SilkyPants/YAAB/Schematics/Revive Board/board.png

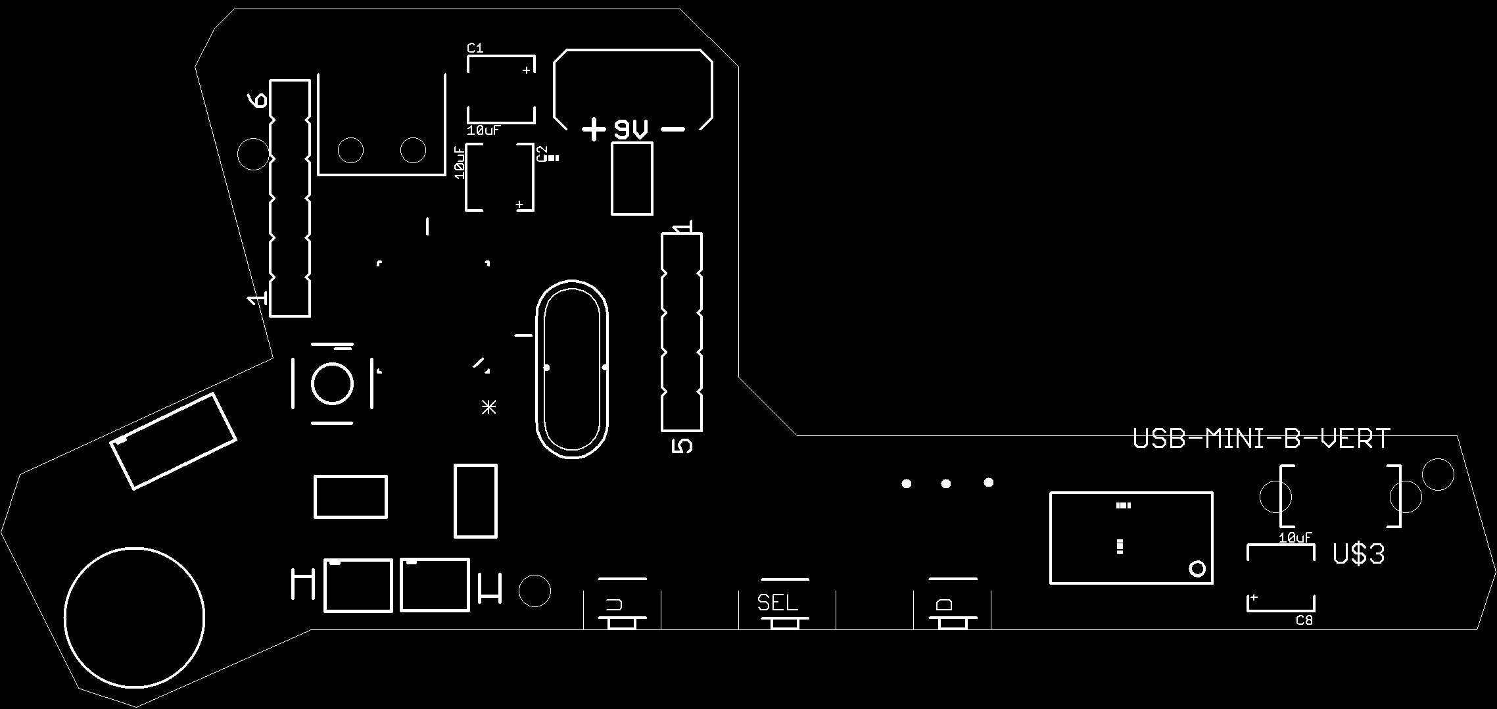
Schematics/Revive Board/board.png
