SilkyPants/YAAB/Schematics/YAAB/YAAB.brd

## EAGLE design Schematics/YAAB/YAAB.brd (2015-05-04)

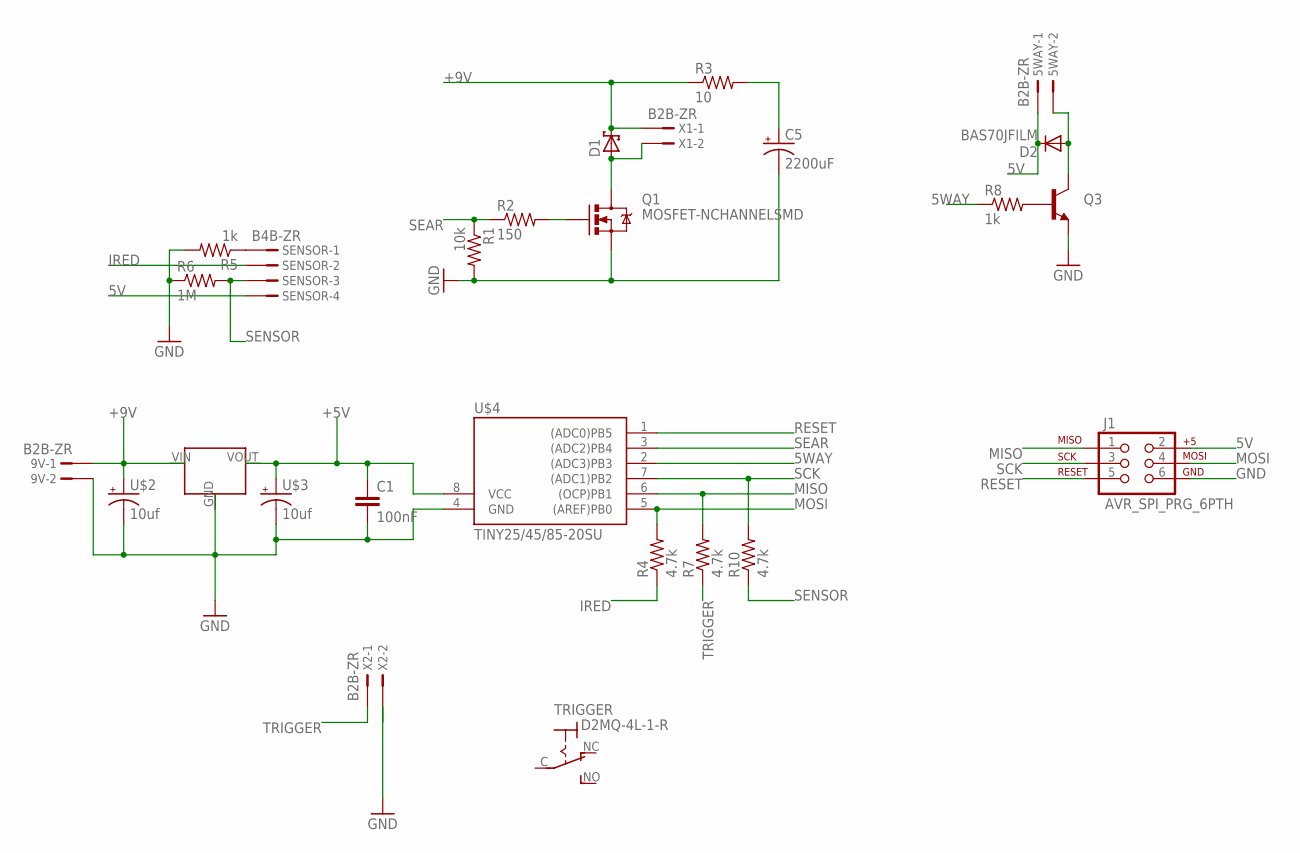
[picture p2: schematic YAAB.sch]

Parts:
5WAY, 9V: B2B-ZR; B2B-ZR@1
C1: 100nF; CAP-PTH-SMALL-KIT
C5: 2200uF; AVES***M**B
D1: SCHOTTKY-DIODESMC; SMC
D2: BAS70JFILM; SOD-323
J1: AVR_SPI_PRG_6PTH; 2X3
Q1: MOSFET-NCHANNELSMD; SOT23-3
Q3: TRANSISTOR_NPNSOT89; SOT89
R1: 10k; 0603-RES
R2: 150; 0603-RES
R3: 10; 0603-RES
R4, R7, R10: 4.7k; 1206
R5, R8: 1k; R0603
R6: 1M; R0603
SENSOR: B4B-ZR
TRIGGER: D2MQ-4L-1-R
U$1: L78M05C; SOT-89
U$2, U$3: 10uf; AVES***M**B
U$4: TINY25/45/85-20SU; SOIC8
X1: B2B-ZR; B2B-ZR@1
X2: B2B-ZR

Connections:
5V: 5WAY.1, D2.1 (C), J1.2, SENSOR.4
5WAY: R8.1, U$4.2 ((ADC3)PB3)
+5V: C1.1, U$1.VOUT (OUT), U$3.P$1+ (+), U$4.8 (VCC)
+9V: 9V.1, D1.C, R3.1, U$1.VIN (IN), U$2.P$1+ (+), X1.1
GND: 9V.2, C1.2, C5.P$2- (-), J1.6, Q1.2 (S), Q3.3 (E), R1.2, R5.2, R6.1, U$1.GND, U$2.P$2- (-), U$3.P$2- (-), U$4.4 (GND)
IRED: R4.1, SENSOR.2
MISO: J1.1, R7.2, U$4.6 ((OCP)PB1)
MOSI: J1.4, R4.2, U$4.5 ((AREF)PB0)
unnamed: Q1.1 (G), R2.2
unnamed: D1.A, Q1.3 (D), X1.2
unnamed: C5.P$1+ (+), R3.2
unnamed: R5.1, SENSOR.1
unnamed: 5WAY.2, D2.2 (A), Q3.2 (C)
unnamed: Q3.1 (B), R8.2
RESET: J1.5, U$4.1 ((ADC0)PB5)
SCK: J1.3, R10.2, U$4.7 ((ADC1)PB2)
SEAR: R1.1, R2.1, U$4.3 ((ADC2)PB4)
SENSOR: R6.2, R10.1, SENSOR.3
TRIGGER: R7.1, X2.1, X2.2

Board: 2 copper layers, 26 parts (0 on the bottom side), 19 nets, no tracks yet.
