SilkyPants/YAAB/Schematics/Revive Shield/shield.brd

## EAGLE design Schematics/Revive Shield/shield.brd (2015-05-04)

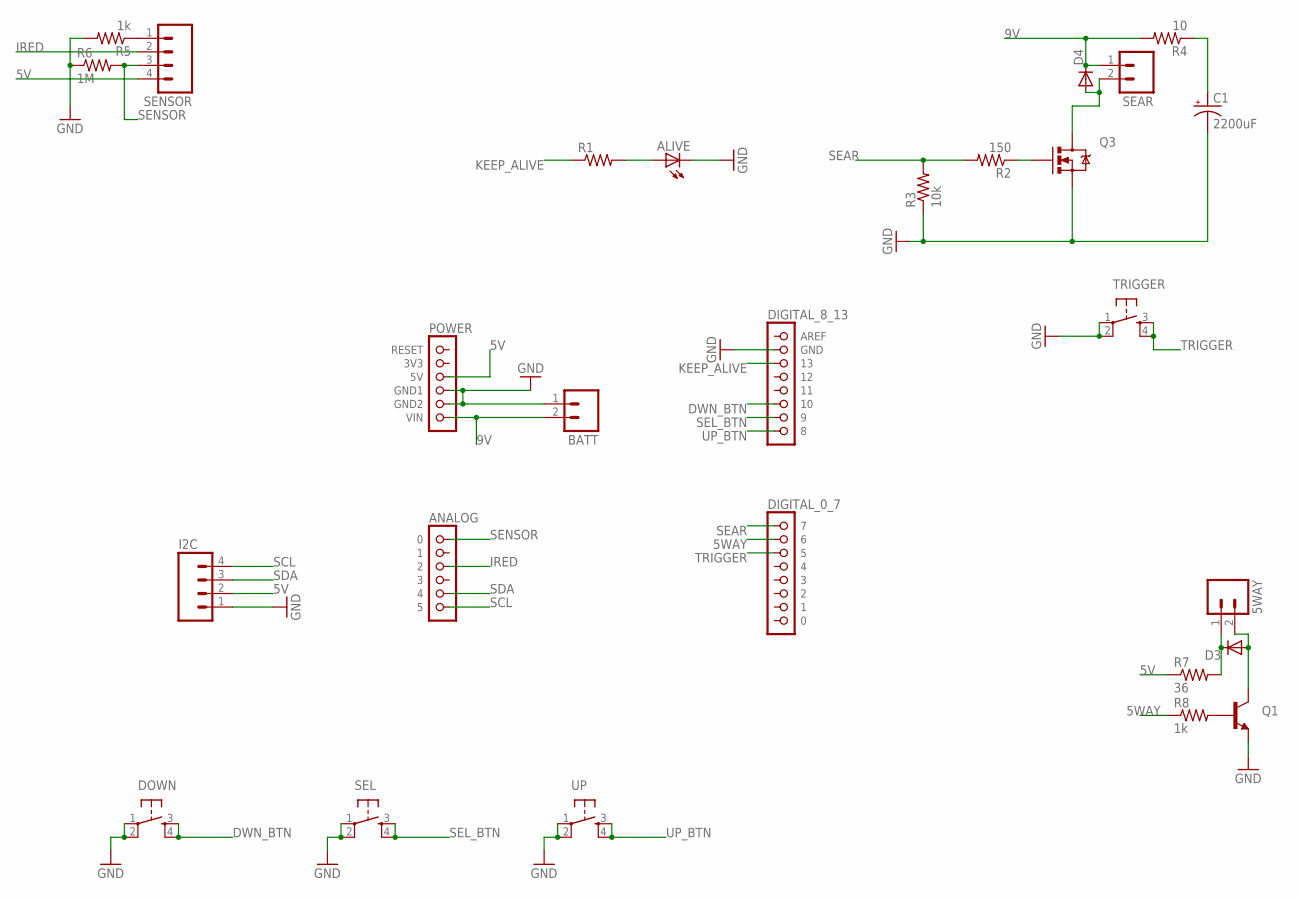
[picture p3: schematic shield.sch]

Parts:
5WAY: M02PTH; 1X02
ALIVE: LED3MM
BATT: M02PTH; 1X02
C1: 2200uF; CPOL-RADIAL-1000UF-25V
D3, D4: DIODEPTH; DIODE-1N4001
DOWN: TAC_SWITCHPTH; TACTILE-PTH
I2C: M04PTH; 1X04
Q1: TRANSISTOR_NPNTO-92-AMMO; TO-92-AMMO
Q3: MOSFET-NCHANNELPTH2; TO220V
R1: RESISTORPTH-1/4W; AXIAL-0.4
R2: 150; AXIAL-0.4
R3: 10k; AXIAL-0.4
R4: 10; AXIAL-0.4
R5, R8: 1k; AXIAL-0.4
R6: 1M; AXIAL-0.4
R7: 36; AXIAL-0.4
SEAR: M02PTH; 1X02
SEL: TAC_SWITCHPTH; TACTILE-PTH
SENSOR: M04PTH; 1X04
TRIGGER: TAC_SWITCHPTH; TACTILE-PTH
U$1: POWER; 1X06
U$2: ANALOG; 1X06
U$3: DIGITAL_0_7; 1X08
U$4: DIGITAL_8_13; 1X08
UP: TAC_SWITCHPTH; TACTILE-PTH

Connections:
5V: I2C.2, R7.P$1 (1), SENSOR.4, U$1.3 (5V)
5WAY: R8.P$1 (1), U$3.2 (6)
9V: BATT.2, D4.C, R4.P$2 (2), SEAR.1, U$1.6 (VIN)
DWN_BTN: DOWN.3, DOWN.4, U$4.6 (10)
GND: ALIVE.K (C), BATT.1, C1.2 (-), DOWN.1, DOWN.2, I2C.1, Q1.1 (E), Q3.3 (S), R3.P$1 (1), R5.P$2 (2), R6.P$1 (1), SEL.1, SEL.2, TRIGGER.1, TRIGGER.2, U$1.4 (GND1), U$1.5 (GND2), U$4.2 (GND), UP.1, UP.2
IRED: SENSOR.2, U$2.3 (2)
KEEP_ALIVE: R1.P$1 (1), U$4.3 (13)
unnamed: Q1.2 (B), R8.P$2 (2)
unnamed: ALIVE.A, R1.P$2 (2)
unnamed: Q3.1 (G), R2.P$1 (1)
unnamed: C1.1 (+), R4.P$1 (1)
unnamed: 5WAY.1, D3.C, R7.P$2 (2)
unnamed: R5.P$1 (1), SENSOR.1
unnamed: D4.A, Q3.2 (D), SEAR.2
unnamed: 5WAY.2, D3.A, Q1.3 (C)
SCL: I2C.4, U$2.6 (5)
SDA: I2C.3, U$2.5 (4)
SEAR: R2.P$2 (2), R3.P$2 (2), U$3.1 (7)
SEL_BTN: SEL.3, SEL.4, U$4.7 (9)
SENSOR: R6.P$2 (2), SENSOR.3, U$2.1 (0)
TRIGGER: TRIGGER.3, TRIGGER.4, U$3.3 (5)
UP_BTN: U$4.8, UP.3, UP.4

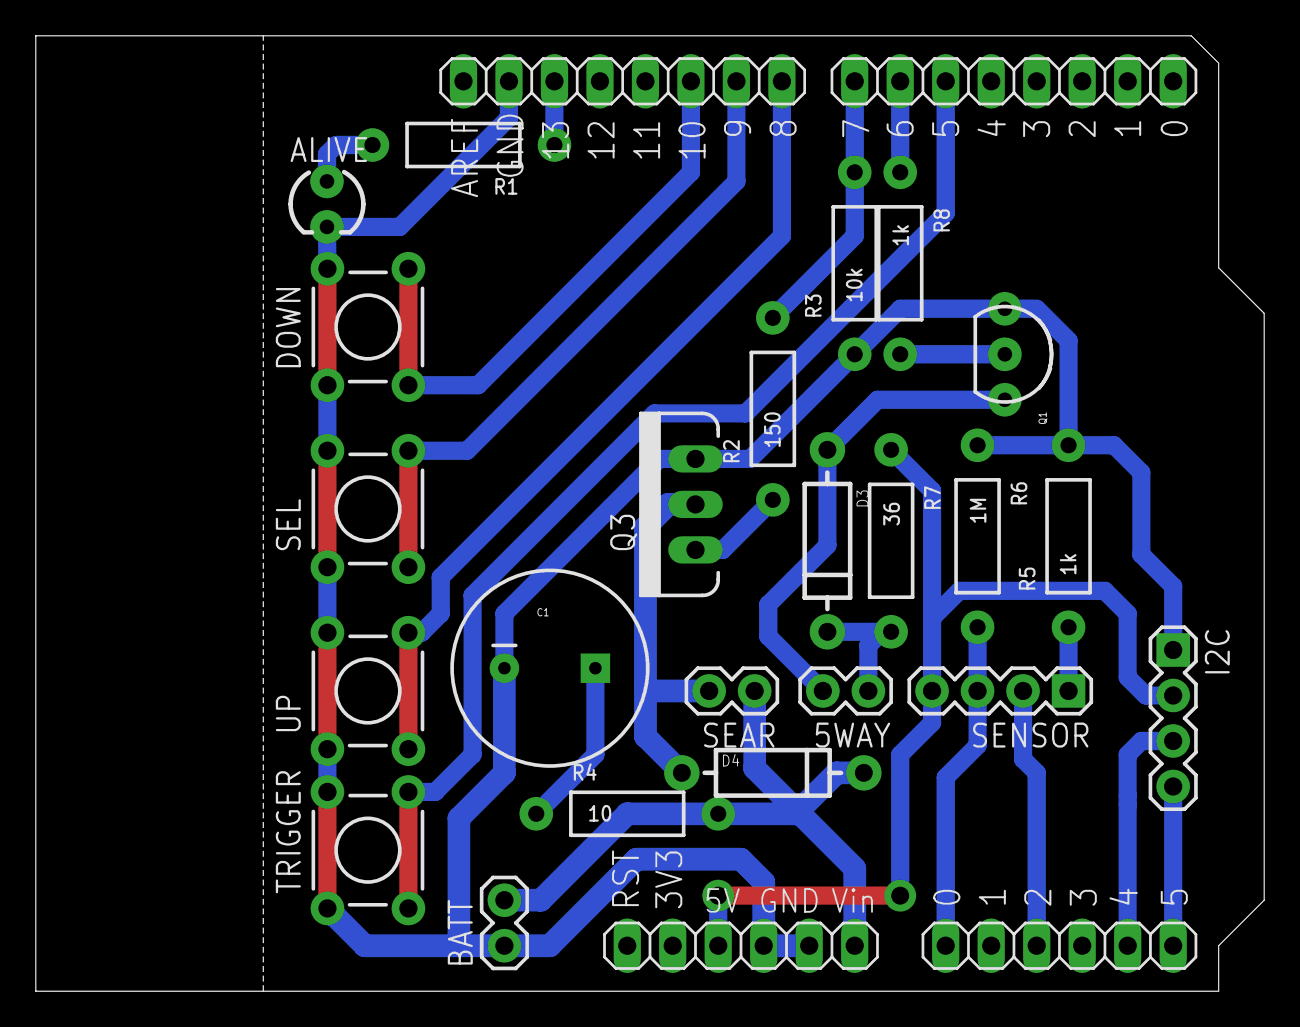
[picture p4: board shield.brd from above]

Board: 2 copper layers, 68.6 x 53.3 mm, 27 parts (0 on the bottom side), 22 nets.
