SilkyPants/YAAB/Schematics/Revive Board/Board Layout.brd

## EAGLE design Schematics/Revive Board/Board Layout.brd (2015-05-04)

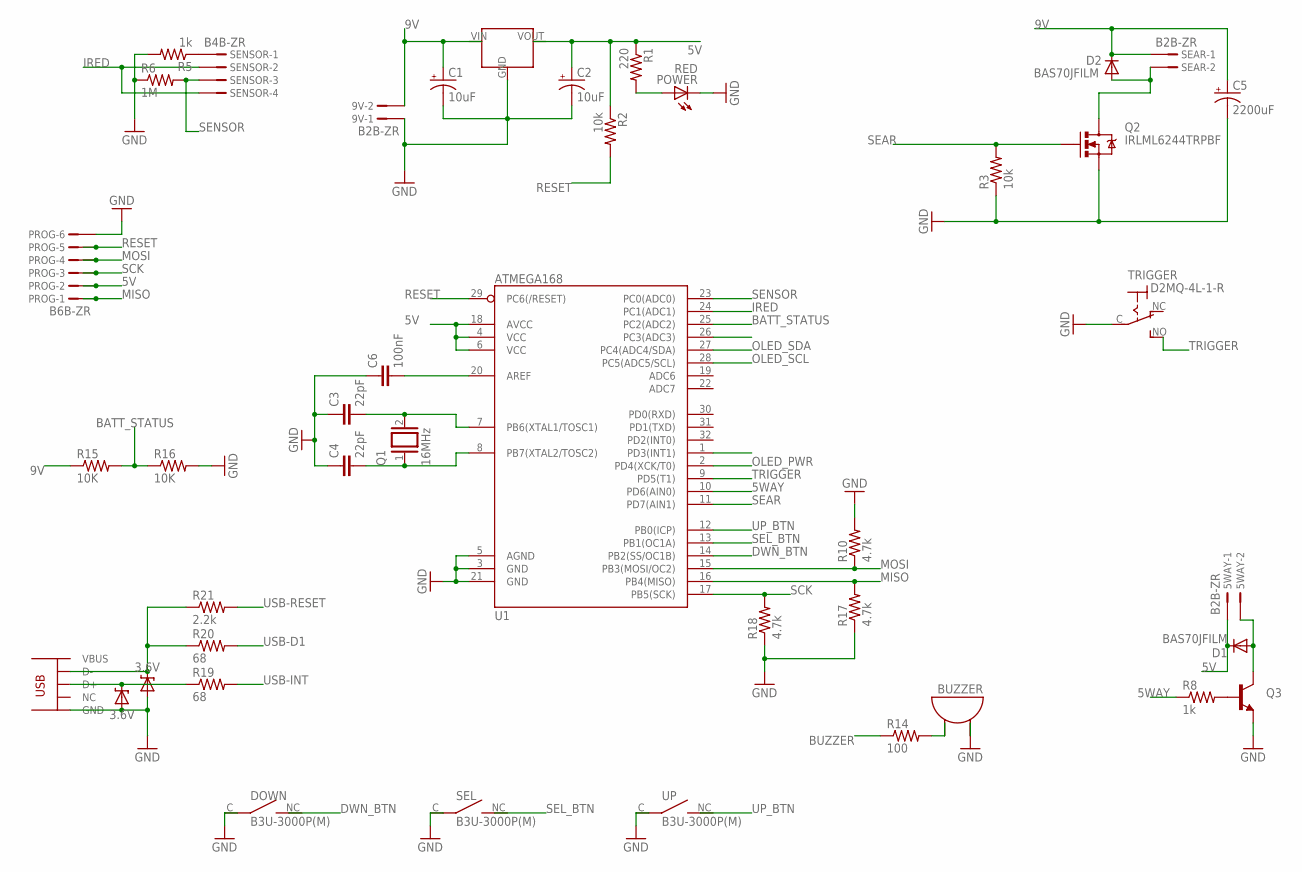
[picture p5: schematic Board Layout.sch]

Parts:
3.6V: 3.6V; SOD-323
5WAY, 9V: B2B-ZR
BUZZER: KPEG171
C1, C2: 10uF; AVES***M**B
C3, C4: 22pF; 0402-CAP
C5: 2200uF; AVES***M**B
C6: 100nF; 0402-CAP
D1, D2: BAS70JFILM; SOD-323
DOWN: B3U-3000P(M)
MAX603: 7805; SOT-89
POWER: RED; CHIP-LED0603
PROG: B6B-ZR
Q1: 16MHz; QS
Q2: IRLML6244TRPBF; SOT23-3
Q3: TRANSISTOR_NPNSOT89; SOT89
R1: 220; R0603
R2, R3: 10k; R0603
R5, R8: 1k; R0603
R6: 1M; R0603
R10, R17, R18: 4.7k; R0603
R14: 100; R0603
R15, R16: 10K; R0603
R19, R20: 68; R0603
R21: 2.2k; R0603
SEAR: B2B-ZR
SEL: B3U-3000P(M)
SENSOR: B4B-ZR
TRIGGER: D2MQ-4L-1-R
U1: ATMEGA168; TQFP32-08
U$2: 3.6V; SOD-323
U$3: USB-MINI-B-VERT
UP: B3U-3000P(M)

Connections:
5V: 5WAY.1, C2.P$1+ (+), D1.1 (C), MAX603.VOUT (OUT), PROG.2, R1.1, R2.1, U1.4 (VCC), U1.6 (VCC), U1.18 (AVCC)
5WAY: R8.1, U1.10 (PD6(AIN0))
9V: 9V.2, C1.P$1+ (+), C5.P$1+ (+), D2.1 (C), MAX603.VIN (IN), R15.1, SEAR.1
BATT_STATUS: R15.2, R16.1, U1.25 (PC2(ADC2))
BUZZER: R14.1
DWN_BTN: DOWN.NC (NO), U1.14 (PB2(SS/OC1B))
GND: 3.6V.2 (A), 9V.1, BUZZER.2 (PB2), C1.P$2- (-), C2.P$2- (-), C3.1, C4.1, C5.P$2- (-), C6.1, DOWN.C, POWER.C, PROG.6, Q2.2 (S), Q3.3 (E), R3.1, R5.2, R6.1, R10.2, R16.2, R17.1, R18.1, SEL.C, TRIGGER.C, U1.3 (GND), U1.5 (AGND), U1.21 (GND), U$2.2 (A), UP.C
IRED: SENSOR.2, SENSOR.4, U1.24 (PC1(ADC1))
MISO: PROG.1, R17.2, U1.16 (PB4(MISO))
MOSI: PROG.4, R10.1, U1.15 (PB3(MOSI/OC2))
unnamed: C3.2, Q1.2, U1.7 (PB6(XTAL1/TOSC1))
unnamed: C4.2, Q1.1, U1.8 (PB7(XTAL2/TOSC2))
unnamed: C6.2, U1.20 (AREF)
unnamed: POWER.A, R1.2
unnamed: D2.2 (A), Q2.3 (D), SEAR.2
unnamed: R5.1, SENSOR.1
unnamed: R20.1, R21.1, U$2.1 (C)
unnamed: 3.6V.1 (C), R19.1
unnamed: 5WAY.2, D1.2 (A), Q3.2 (C)
unnamed: Q3.1 (B), R8.2
unnamed: BUZZER.1 (PB1), R14.2
OLED_PWR: U1.2 (PD4(XCK/T0))
OLED_SCL: U1.28 (PC5(ADC5/SCL))
OLED_SDA: U1.27 (PC4(ADC4/SDA))
RESET: PROG.5, R2.2, U1.29 (PC6(/RESET))
SCK: PROG.3, R18.2, U1.17 (PB5(SCK))
SEAR: R3.2, U1.11 (PD7(AIN1))
SEL_BTN: SEL.NC (NO), U1.13 (PB1(OC1A))
SENSOR: R6.2, SENSOR.3, U1.23 (PC0(ADC0))
TRIGGER: TRIGGER.NO (S), U1.9 (PD5(T1))
UP_BTN: U1.12 (PB0(ICP)), UP.NC (NO)
USB-D1: R20.2
USB-INT: R19.2
USB-RESET: R21.2

Board: 2 copper layers, 42 parts (0 on the bottom side), 27 nets, no tracks yet.
