SilkyPants/YAAB/YAAB/crius_oled.cpp

/*
YAAB - Yet Another Autococker Board
Arduino based autococker board developed around the platform and ATMEL AVR
chips

Copyright (C) 2013  Dan Silk

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
You should have received a copy of the GNU General Public License
along with this program.  If not, see <http://www.gnu.org/licenses/>.
*/

#include <stdlib.h>
#include <avr/pgmspace.h>

#include "common.h"
#include <util/delay.h>
#include "pins.h"

#include "font.h"
#include "i2c.h"
#include "crius_oled.h"

#define OLED_address  0x3c

#define SSD1306_SETCONTRAST		0x81
#define SSD1306_CONTRASTDULL	0x01
#define SSD1306_CONTRASTBRIGHT	0xFF

#define SSD1306_REMAPSEG0TO0	0xA0
#define SSD1306_REMAPSEG0TO127	0xA1

#define SSD1306_NORMALCOMSCAN	0xC0
#define SSD1306_REVERSECOMSCAN	0xC8

#define SSD1306_DISPLAYALLON_RESUME 0xA4
#define SSD1306_DISPLAYALLON 0xA5
#define SSD1306_NORMALDISPLAY 0xA6
#define SSD1306_INVERTDISPLAY 0xA7
#define SSD1306_DISPLAYOFF 0xAE
#define SSD1306_DISPLAYON 0xAF

#define SSD1306_SETDISPLAYOFFSET 0xD3
#define SSD1306_SETCOMPINS 0xDA

#define SSD1306_SETVCOMDETECT 0xDB

#define SSD1306_SETDISPLAYCLOCKDIV 0xD5
#define SSD1306_SETPRECHARGE 0xD9

#define SSD1306_SETMULTIPLEX 0xA8

#define SSD1306_SETLOWCOLUMN 0x00
#define SSD1306_SETHIGHCOLUMN 0x10

#define SSD1306_SETSTARTLINE 0x40

#define SSD1306_MEMORYMODE 0x20
#define SSD1306_VERTICAL_ADDRESS_MODE 0x01

#define SSD1306_COMSCANINC 0xC0
#define SSD1306_COMSCANDEC 0xC8

#define SSD1306_SEGREMAP 0xA0

#define SSD1306_CHARGEPUMP 0x8D

#define SSD1306_EXTERNALVCC 0x1
#define SSD1306_SWITCHCAPVCC 0x2

// Scrolling #defines
#define SSD1306_ACTIVATE_SCROLL 0x2F
#define SSD1306_DEACTIVATE_SCROLL 0x2E
#define SSD1306_SET_VERTICAL_SCROLL_AREA 0xA3
#define SSD1306_RIGHT_HORIZONTAL_SCROLL 0x26
#define SSD1306_LEFT_HORIZONTAL_SCROLL 0x27
#define SSD1306_VERTICAL_AND_RIGHT_HORIZONTAL_SCROLL 0x29
#define SSD1306_VERTICAL_AND_LEFT_HORIZONTAL_SCROLL 0x2A

unsigned char buffer[ LCD_BUFFER_SIZE ] =
{
	0x00,0x00,0x00,0x00,0x00,0x00,0x00,0x00,0xFE,0xFF,0xFF,0xFF,0xFF,0xFF,0xFF,0x7F,0x02,0x00,0x00,0x00,0x00,0x00,0x00,0x40,0xFA,0x2F,0x00,0x00,0x00,0x00,0x00,0x40,0x0A,0x28,0x00,0x00,0x00,0x00,0x00,0x40,0x0A,0x28,0x00,0x00,0x00,0x00,0x00,0x40,0x02,0x20,0x00,0x00,0x00,0x00,0x00,0x40,0x02,0x20,0x00,0x00,0x00,0x00,0x00,0x40,0x02,0x20,0x00,0x00,0x00,0x00,0x00,0x40,0x0A,0x28,0x00,0x00,0x00,0x00,0x00,0x40,0x0A,0x28,0x00,0x00,0x00,0x00,0x00,0x40,0xFA,0x2F,0x00,0x00,0x00,0x00,0x00,0x40,0x02,0x20,0x00,0x00,0x00,0x00,0x00,0x40,0x02,0x20,0x00,0x00,0x00,0x00,0x00,0x40,0x02,0x20,0x00,0x00,0x00,0x00,0x00,0x40,0x02,0x20,0x00,0x00,0x00,0x00,0x00,0x40,0x02,0x20,0x00,0x00,0x00,0x00,0x00,0x40,0x02,0x20,0x00,0x00,0x00,0x00,0x00,0x40,0x02,0x20,0x00,0x00,0x00,0x00,0x00,0x40,0x02,0x20,0x00,0x00,0x00,0x00,0x00,0x40,0x02,0x20,0x00,0x00,0x00,0x00,0x00,0x40,0x02,0x20,0x00,0x00,0x00,0x00,0x00,0x40,0x02,0x20,0x00,0x00,0x00,0x00,0x00,0x40,0x02,0x20,0x00,0x00,0x00,0x00,0x00,0x40,0x02,0x20,0x00,0x00,0x00,0x00,0x00,0x40,0x02,0x20,0x00,0x00,0x00,0x00,0x00,0x40,0x02,0x20,0x00,0x00,0x00,0x00,0x00,0x40,0x02,0x20,0x00,0x00,0x00,0x00,0x00,0x40,0x02,0x20,0x00,0x00,0x00,0x00,0x00,0x40,0x02,0x20,0x00,0x00,0x00,0x00,0x00,0x40,0x02,0x20,0x00,0x00,0x00,0x00,0x00,0x40,0x02,0x20,0x00,0x00,0x00,0x00,0x00,0x40,0x02,0x20,0x00,0x00,0x00,0x00,0x00,0x40,0x02,0x20,0x00,0x00,0x00,0x00,0x00,0x40,0x02,0x20,0x00,0x00,0x00,0x00,0x00,0x40,0x02,0x20,0x00,0x00,0x00,0x00,0x00,0x40,0x02,0x20,0x00,0x00,0x00,0x00,0x00,0x40,0x02,0x20,0x00,0x00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
		buffer[ pageIdx ] |= 1 << pixelIdx;
	else
		buffer[ pageIdx ] &= ~( 1 << pixelIdx );
}

const unsigned char * GetFont( FontType font )
{
	switch( font )
	{
		case BPS_FONT:
			return BPSFont;
			
		case LARGE_FONT:
			return LargeFont;
		
		case SMALL_FONT:
		default:
			return SmallFont;
	}
}

void drawCharInternal( int x, int y, unsigned char character, const unsigned char * font )
{	
	uint8_t startChar = pgm_read_byte_near(font + 2);
	uint8_t charWidth = pgm_read_byte_near(font + 5);
	uint8_t charHeight = pgm_read_byte_near(font + 4);
	
	uint8_t bytesPerCol = ( charHeight / 8 ) + 1;
	int16_t charIdx = ( ( character - startChar ) * ( charWidth * bytesPerCol ) ) + 6;
	
	for( uint8_t bytes = 0; bytes < charWidth; bytes++ )
	{
		for( uint8_t cols = 0; cols < bytesPerCol; cols++ )
		{
			uint8_t maxBits = charHeight - ( cols * 8 );
			uint16_t offset = charIdx + cols + ( bytes * bytesPerCol);
			uint8_t charByte = pgm_read_byte_near( font + offset );
			
			if( maxBits > 8 )
				maxBits = 8;
			
			for( uint8_t bits = 0; bits < maxBits; bits++ )
			{
				bool bitValue = charByte & ( 1 << bits );
			
				drawPixel( x + bytes, y + ( cols * 8 ) + bits, bitValue );
			}
		}
	}
}

void drawChar( int x, int y, unsigned char character, FontType fontType )
{
    drawCharInternal( x, y, character, GetFont( fontType ) );
}

void drawString( int x, int y, unsigned char * string, FontType fontType )
{
	const unsigned char * font = GetFont( fontType );
	
	uint8_t charWidth = pgm_read_byte_near(font + 5);
	uint8_t charHeight = pgm_read_byte_near(font + 4);
	int runningX = x;
	
	while(*string)
	{
		if( *string == '\n' )
		{
			y += charHeight;
			runningX = x;
		}
		else if( *string == ' ' )
		{
			runningX += charWidth;
		}
		else
		{
			drawCharInternal( runningX, y, *string, font );
			
			runningX += charWidth;
		}
		
        string = string + 1;
	}
}

void swap(int16_t &r, int16_t &s)
{
	int16_t pSwap = r;
	r = s;
	s = pSwap;
	return;
}

void drawLine(int16_t x0, int16_t y0, int16_t x1, int16_t y1)
{
	int16_t steep = abs(y1 - y0) > abs(x1 - x0);
	if (steep) 
	{
		swap(x0, y0);
		swap(x1, y1);
	}

	if (x0 > x1) 
	{
		swap(x0, x1);
		swap(y0, y1);
	}

	int16_t dx, dy;
	dx = x1 - x0;
	dy = abs(y1 - y0);

	int16_t err = dx / 2;
	int16_t ystep;

	if (y0 < y1) 
	{
		ystep = 1;
    }
    else
    {
		ystep = -1;
	}

	for (; x0<=x1; x0++) 
	{
		if (steep) 
		{
			drawPixel(y0, x0, true);
        }
        else
        {
			drawPixel(x0, y0, true);
        }
		err -= dy;
		if (err < 0) 
		{
			y0 += ystep;
			err += dx;
		}
	}
}

void fillRect( int x, int y, int w, int h, bool fill )
{
	for( int i = x; i < x + w; i++ )
	{
		for( int j = y; j < y + h; j++ )
		{
			drawPixel( i, j, fill );
		}	
	}
}

//==========================================================//
void clear_display(void)
{
	for(int i = 0; i < LCD_BUFFER_SIZE; i++)    
	{
		senddata(0);
	}
}

//==========================================================//
void setXY(unsigned char row,unsigned char col)
{
	sendcommand(0xb0+row);                //set page address
	sendcommand(0x00+(8*col&0x0f));       //set low col address
	sendcommand(0x10+((8*col>>4)&0x0f));  //set high col address
}

//==========================================================//
void init_OLED(void)
{
	set_output(CYCLE_PORT_REG, 4);
	_delay_ms(20);
	output_high(CYCLE_PORT, 4);

	_delay_ms(50);
	
	sendcommand( SSD1306_DISPLAYOFF );
	sendcommand( SSD1306_DEACTIVATE_SCROLL );
	sendcommand( SSD1306_DISPLAYALLON_RESUME );
	
	_delay_ms(50);
	
	sendcommand( SSD1306_REMAPSEG0TO127 );
	sendcommand( SSD1306_REVERSECOMSCAN );
	
	sendcommand( SSD1306_NORMALDISPLAY );
	
	sendcommand( SSD1306_MEMORYMODE );
	sendcommand( SSD1306_VERTICAL_ADDRESS_MODE );
	
	sendcommand( SSD1306_SETCONTRAST );
	sendcommand( SSD1306_CONTRASTDULL );
	
	_delay_ms(20);
	
	setXY(0,0);
	clear_display();

	sendcommand( SSD1306_DISPLAYON );          //display on
	
	_delay_ms(20);
}
