SilkyPants/YAAB/YAAB/common.h

/*
YAAB - Yet Another Autococker Board
Arduino based autococker board developed around the platform and ATMEL AVR 
chips

Copyright (C) 2013  Dan Silk

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
You should have received a copy of the GNU General Public License
along with this program.  If not, see <http://www.gnu.org/licenses/>.
*/

#pragma once


#if defined F_CPU
// We want to define the clock speed in the files, not preprocessor?
#undef F_CPU
#endif

// Set this to clock speed
#define F_CPU 16000000U

///
/// Need to define what processor we are using
#ifndef __AVR_ATmega328P__
#define __AVR_ATmega328P__

//#ifndef __AVR_ATtiny85__
//#define __AVR_ATtiny85__

//#ifndef __AVR_ATtiny84__
//#define __AVR_ATtiny84__
#endif

///
/// Whether to use the full Arduino libraries or not (allows serial loading/debug etc)
//#define USE_ARDUINO

///
/// ADC Completes faster
#define FASTER_ADC

///
/// Enabled the ability to select and use full Automatic and Burst fire modes
//#define AUTO_ALLOWED

///
/// Used to blink an LED in the loop - to make sure the program is running
//#define KEEP_ALIVE_ACTIVE

///
/// Enable the use of the game timer
#define GAME_TIMER

#if defined USE_ARDUINO

#include "Arduino.h"

///
/// Enable serial output
#define SERIAL_DEBUG

#else

#include <avr/interrupt.h>
#include <avr/io.h>
#include <stdio.h>

#endif

///
/// Some macros that make the code more readable
#define flag_set(flag) _BV(flag)
#define flag_invert(flag) ~_BV(flag)

#define bit_set(val, bit) val |= flag_set(bit)
#define bit_clear(val, bit) val &= flag_invert(bit)
#define bit_toggle(val, bit) val ^= flag_set(bit)
#define is_bit_set(val, bit) ( ( ( val & flag_set( bit ) ) ) != 0 )

#define high_nybble(byte) ((byte >> 4) & 0x0F)
#define low_nybble(byte) ((byte) & 0x0F)

#define set_input(portdir,pin) bit_clear(portdir,pin)
#define set_output(portdir,pin) bit_set(portdir,pin)

#define output_low(port,pin) bit_clear(port,pin)
#define output_high(port,pin) bit_set(port,pin)
#define output_toggle(port,pin) bit_toggle(port,pin)
#define input_value(port,pin) is_bit_set(port,pin)
