SilkyPants/YAAB/(commit log)

2012-02-08 Initial Commit
    Currently sits in full auto mode - still researching best way to handle
    trigger bounce.
    Hard coded E-Blade Fast settings for testing purposes.
2012-02-08 First Pass Basics
    Moved trigger scanning into timer interrupt
    Added debounce to trigger
    Added a few more macros to aid programming
2012-02-09 Extended Fire Modes
    Added ability for firing on release and bursts
    Increased slow down timer
2012-02-09 Missed the stage
2012-02-20 Split Cycle Values into two structures - one for timing and one for firing profiles (as the profiles will change but the timing should stay constant) Moved eyes out to global - might not be useful fo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
2012-02-25 Memory Shuffling
    Moved booleans into byte with flags
    Timing code now has reset for factory settings
    [YAAB.ino]
2012-02-27 Broken down settings into more usable structs with bitfields
    [YAAB.ino]
2012-02-27 Start on Eye logic and fixed bug with setting shots to fire
    [YAAB.ino]
2012-04-17 Bit of tidy work - trying to fix broken-ness Hope to get it running again
    [YAAB.ino]
2012-04-19 More rework Mostly fat trimming and restructure
    [YAAB.ino]
2012-04-20 Now building in Arduino
2012-04-26 More shuffling of settings Added ability to start/stop timer
2012-04-26 Removed bolt seen for now
2012-04-27 Start of new Task based system Idea is to have a list of tasks the cycle needs to do to complete, then only call the current task in the ISR
2012-04-27 Actually using an IntervalLapse Task and fixed a typo
    [Task.h, YAAB.ino]
2012-04-27 Fixed up a few things Added Auto Reset to Interval Task
    [IntervalLapse.h, PinState.h, Task.h, YAAB.ino]
2012-04-27 Woo! Pin Change Task now working!
    Need to do something about the hard coded pin registry pointer
2012-04-27 Pin Change Task now working properly with debounce
2012-04-30 Created start of Game Timer class More work with Tasks, created another class for Time Critical Tasks Added Comment to show values and their ranges in settings Removed old interrupt code as it's no l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
    [GameTimer.h, IntervalLapse.h, PinState.h, Task.h, YAAB.ino, common.h, pins.h]
2012-05-05 All working again
    Few silly mistakes - need to stop working without the board
    [PinState.h, Task.h, YAAB.ino, common.h]
2012-09-21 Reshuffle of code
    Moved feature defines into common for easier changing
    Added ability to build without Arduino libraries - saves ~300 bytes
2012-09-21 More refactoring
    ADC and Timer functions now moved to cpp files - code as bloated a
    little
2012-09-28 Testing Arduino mode
    Also changed for loop in main to while - reads better
2012-11-15 Few little things
    Added Get for current eye value
    Fixed up serial code for eye
    Added null to time string
    [BreechEyesTask.h]
2012-11-20 Simplified the game timer
    Split the timers into a single class, and added reset functionality
    Renamed files to reflect what is inside
    [Timer.cpp, Timer.h]
2012-12-18 Tidied up timer code, and some error reporting
    Added catch if trying to compile for an ATTiny*5 with a clock speed
    greater than 8MHz
    Timer code now cleaner in actual definition
    Added #defines for supported chips, this should be removed later
    [common.h, pins.h, timers.cpp]
2013-12-05 Updated to build on latest version of Arduino IDE
    Had to rename main.h/.cpp as it seems that the naming causes the Arduino IDE to not compile a main function.
2013-12-06 Renamed mainx to marker to make intentions clearer Fixed spelling mistake
    [YAAB.ino, marker.cpp, marker.h, timers.cpp]
2013-12-06 Removed virtual destructor on Task class - saves a fair bit of program size! Added solution files for Atmel Studio 6.1 to build both Arduino and AVR (no Arduino libs) versions
2013-12-06 Merged over OLED code into project. Now pushing 64% RAM due to screen buffer.
    UNTESTED ON DEVICE AS OF YET!
2013-12-09 Moved font and Borders to program space to save memory Initialised buffer to borders for now - do we really need it? Fixed drawString/drawChar to access program space for characters Put test menu in 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
    [crius_oled.cpp, marker.cpp]
2013-12-09 Swapped to normal display Moved render into loop to update display ASAP
    [crius_oled.cpp, marker.cpp]
2013-12-10 Added ability to draw strings in a given font from programming space Added function to fill/clear an area of the buffer Added simple demo for battery level and drain
2013-12-19 Fixed spelling mistake Enabled input buttons for future testing Added more strings
    [marker.cpp, settings.h, strings.h]
2013-12-23 ADC now working for eye - need to rethink free running if we want to use battery monitor in future.
2013-12-24 Moved trigger pin to pin 5, as it’s not running on an interrupt anymore.
2013-12-30 Created Arduino solution for AVR Studio, compatible with Arduino build chain.
2014-01-04 Renamed projects so the Arduino build can work with the Arduino IDE Arduino Atmel Studio build adds the USE_ARDUINO flag in the project
2015-05-04 Created Xcode project for use with x-avr/AVR Crosspack (https://github.com/jawher/xavr) Moved source to separate folder - Arduino .ino file must live there to keep it building. Moved AVR main functio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
2015-05-04 Added EagleCAD schematics and board designs Added OLED design and font files Fixed warning in crius_oled drawString function
    [Board Layout.brd, Board Layout.sch, Board.brd, Board.sch, YAAB.brd, YAAB.sch, shield v2.brd, shield v2.sch]
2015-05-04 Fixed Full Auto flag issue Code tidy
    [crius_oled.cpp, crius_oled.h, marker.cpp]
2015-05-04 Moved display code into new UI files Fixed issue where AUTO_ALLOWED was false causing broken builds Fixed PinState task to reference the correct port registry/pins
    [PinState.cpp, PinState.h, UserInterface.cpp, UserInterface.h, common.h, marker.cpp]
2015-05-05 Updated Visual Studio project files to work with the latest SDKs and plugins
    Arduino 1.6.3
    Visual Micro (pre release)
    Visual Studio Community 2013
2015-05-05 Moved eye reading to eye task Attempting to read in the UI now Added function to draw character at a given location Moved battery draw function to UI Code and Comment Tidy
